Daxxn/GarminAPController/Docs/Renders/APController_PCB_Front1.JPG

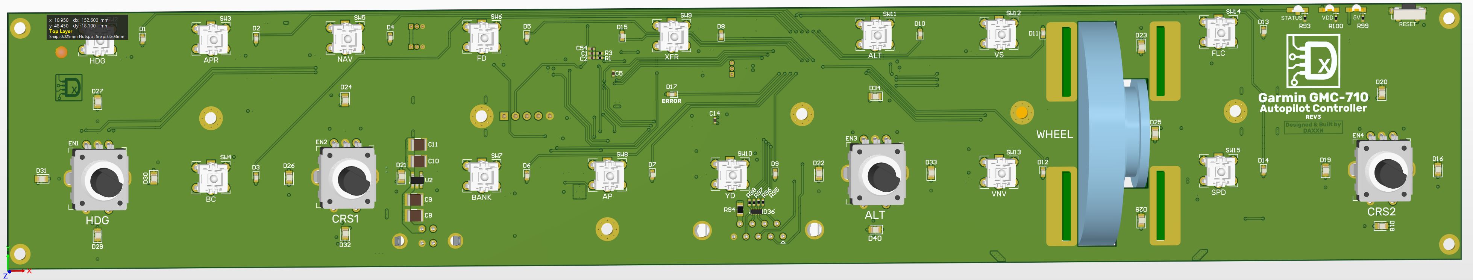
Docs/Renders/APController_PCB_Front1.JPG
