Daxxn/GarminAPController/Docs/Renders/APController_Assembly_Back2.JPG

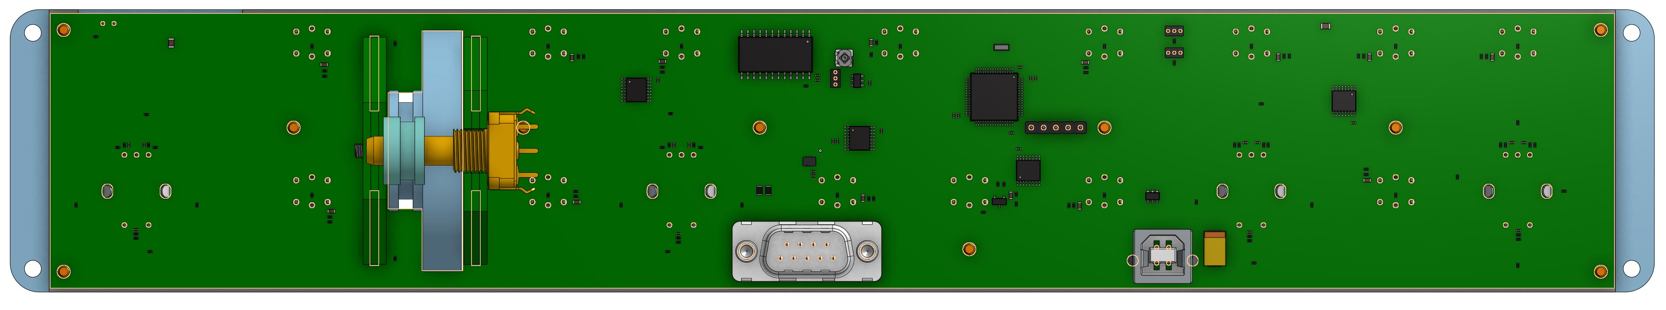
Docs/Renders/APController_Assembly_Back2.JPG
