Daxxn/GarminAPController/Docs/Renders/APController_Assembly_Front1.JPG

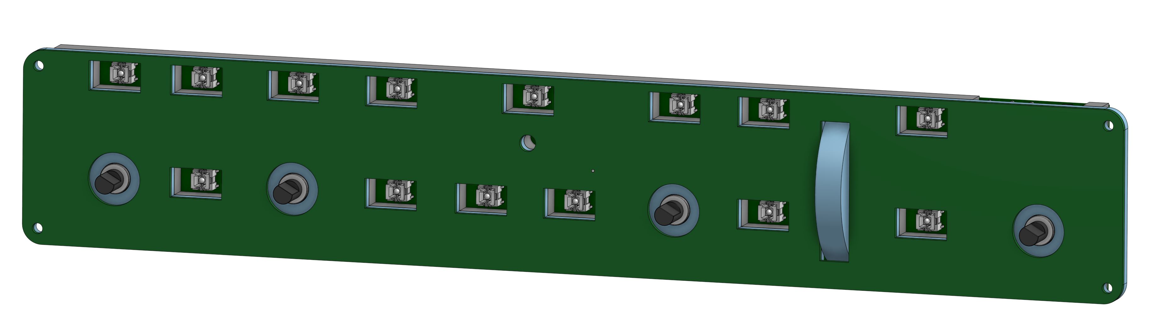
Docs/Renders/APController_Assembly_Front1.JPG
