Daxxn/GarminAPController/Docs/GarminAutopilotREV3.pdf

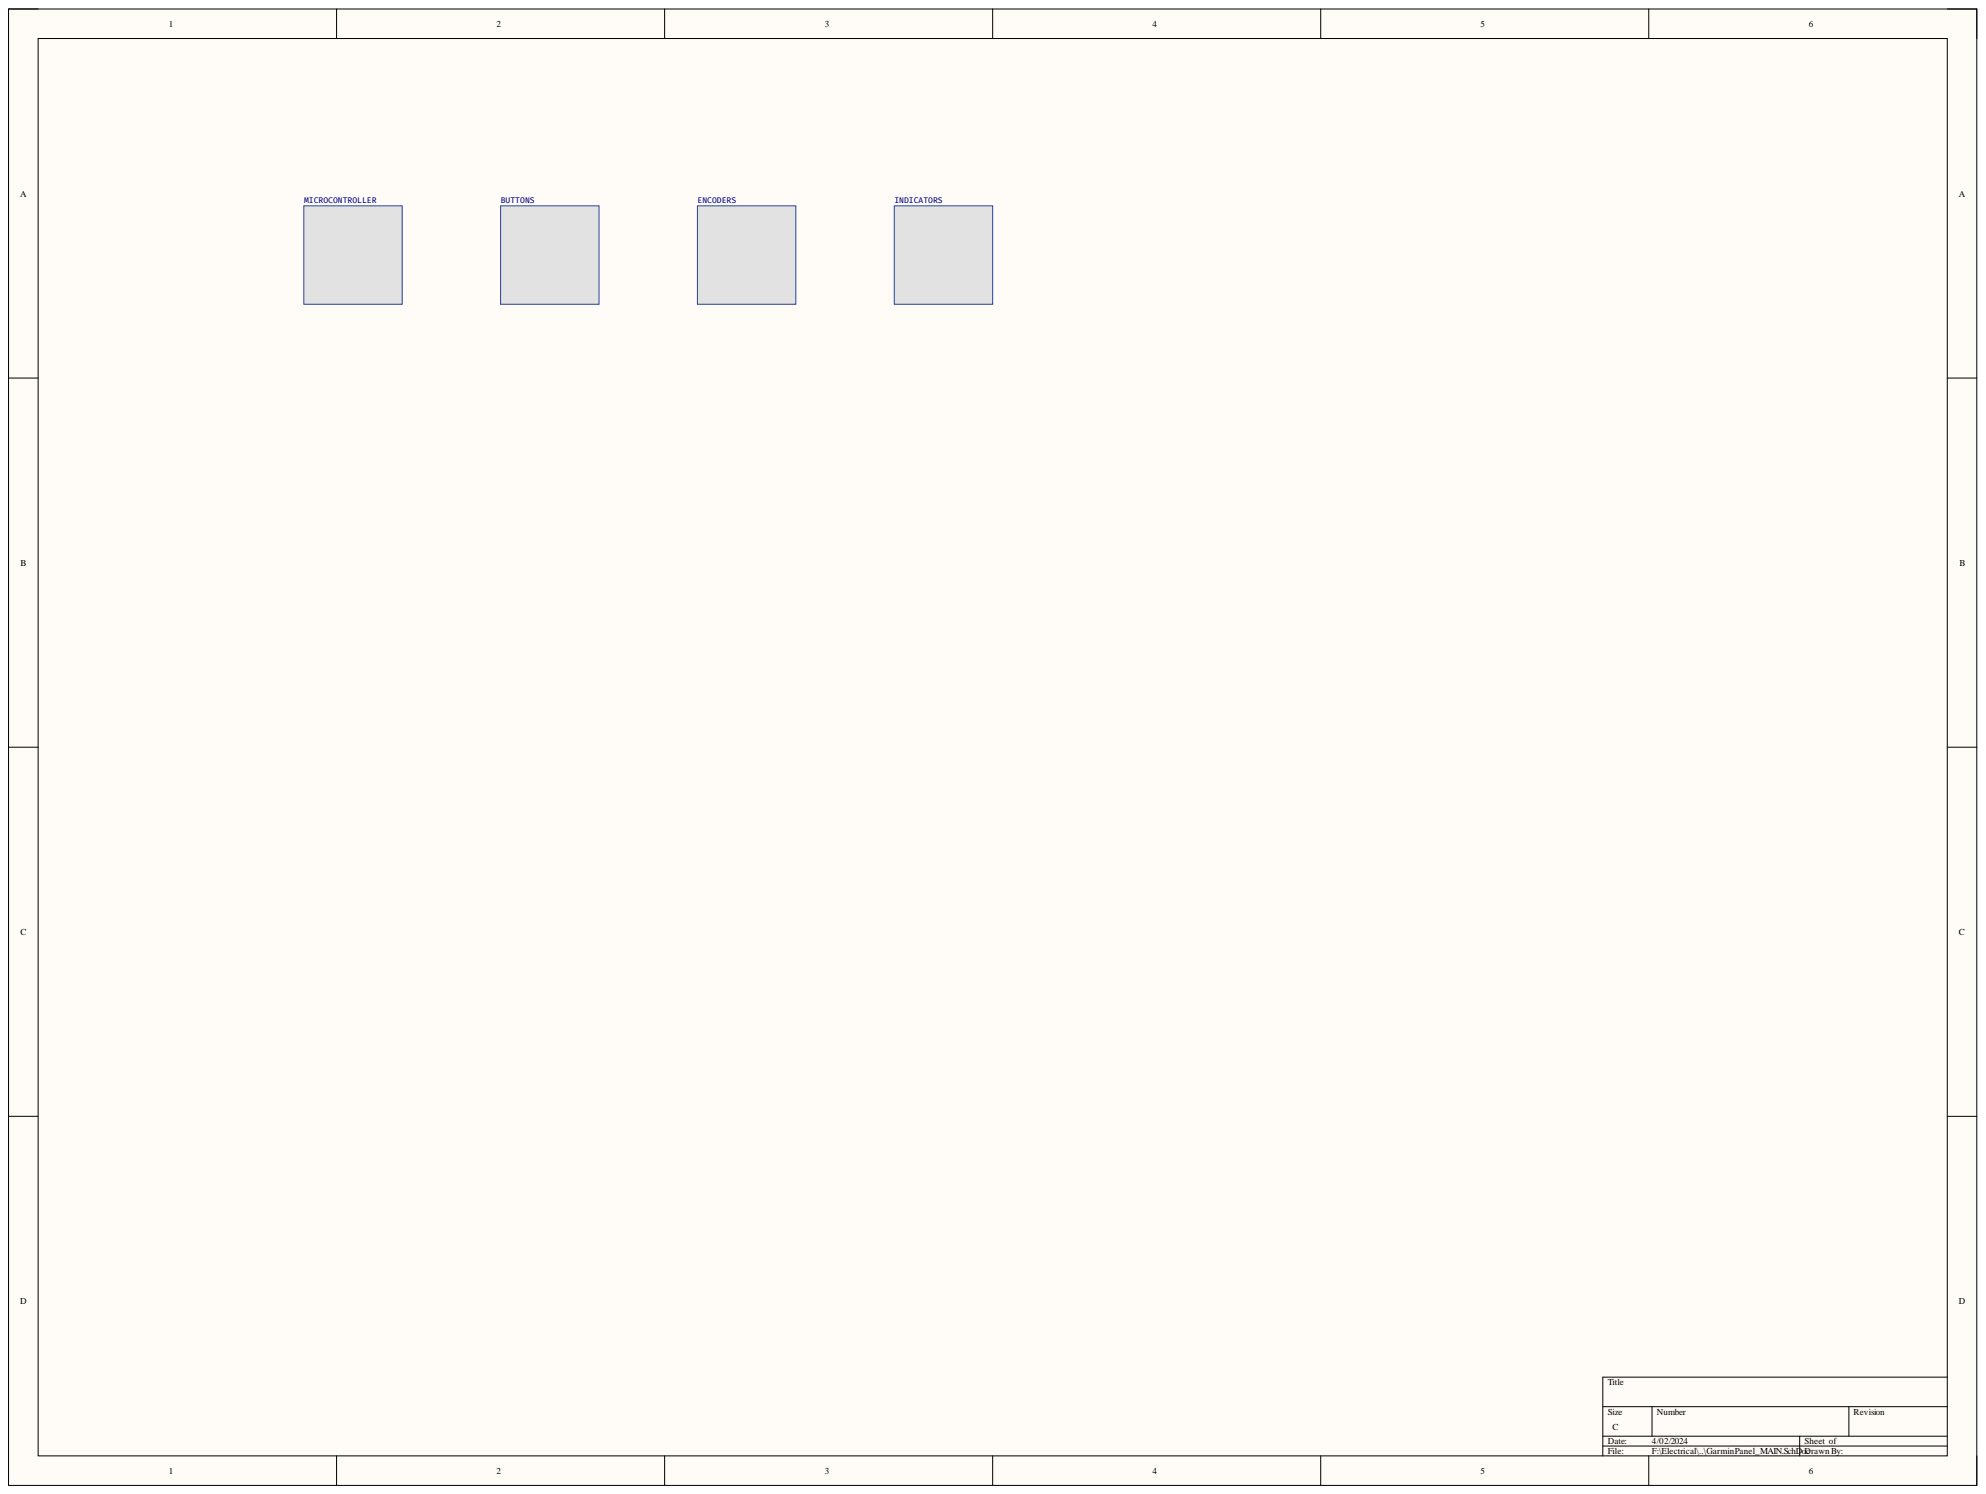
[picture p11: page 1]

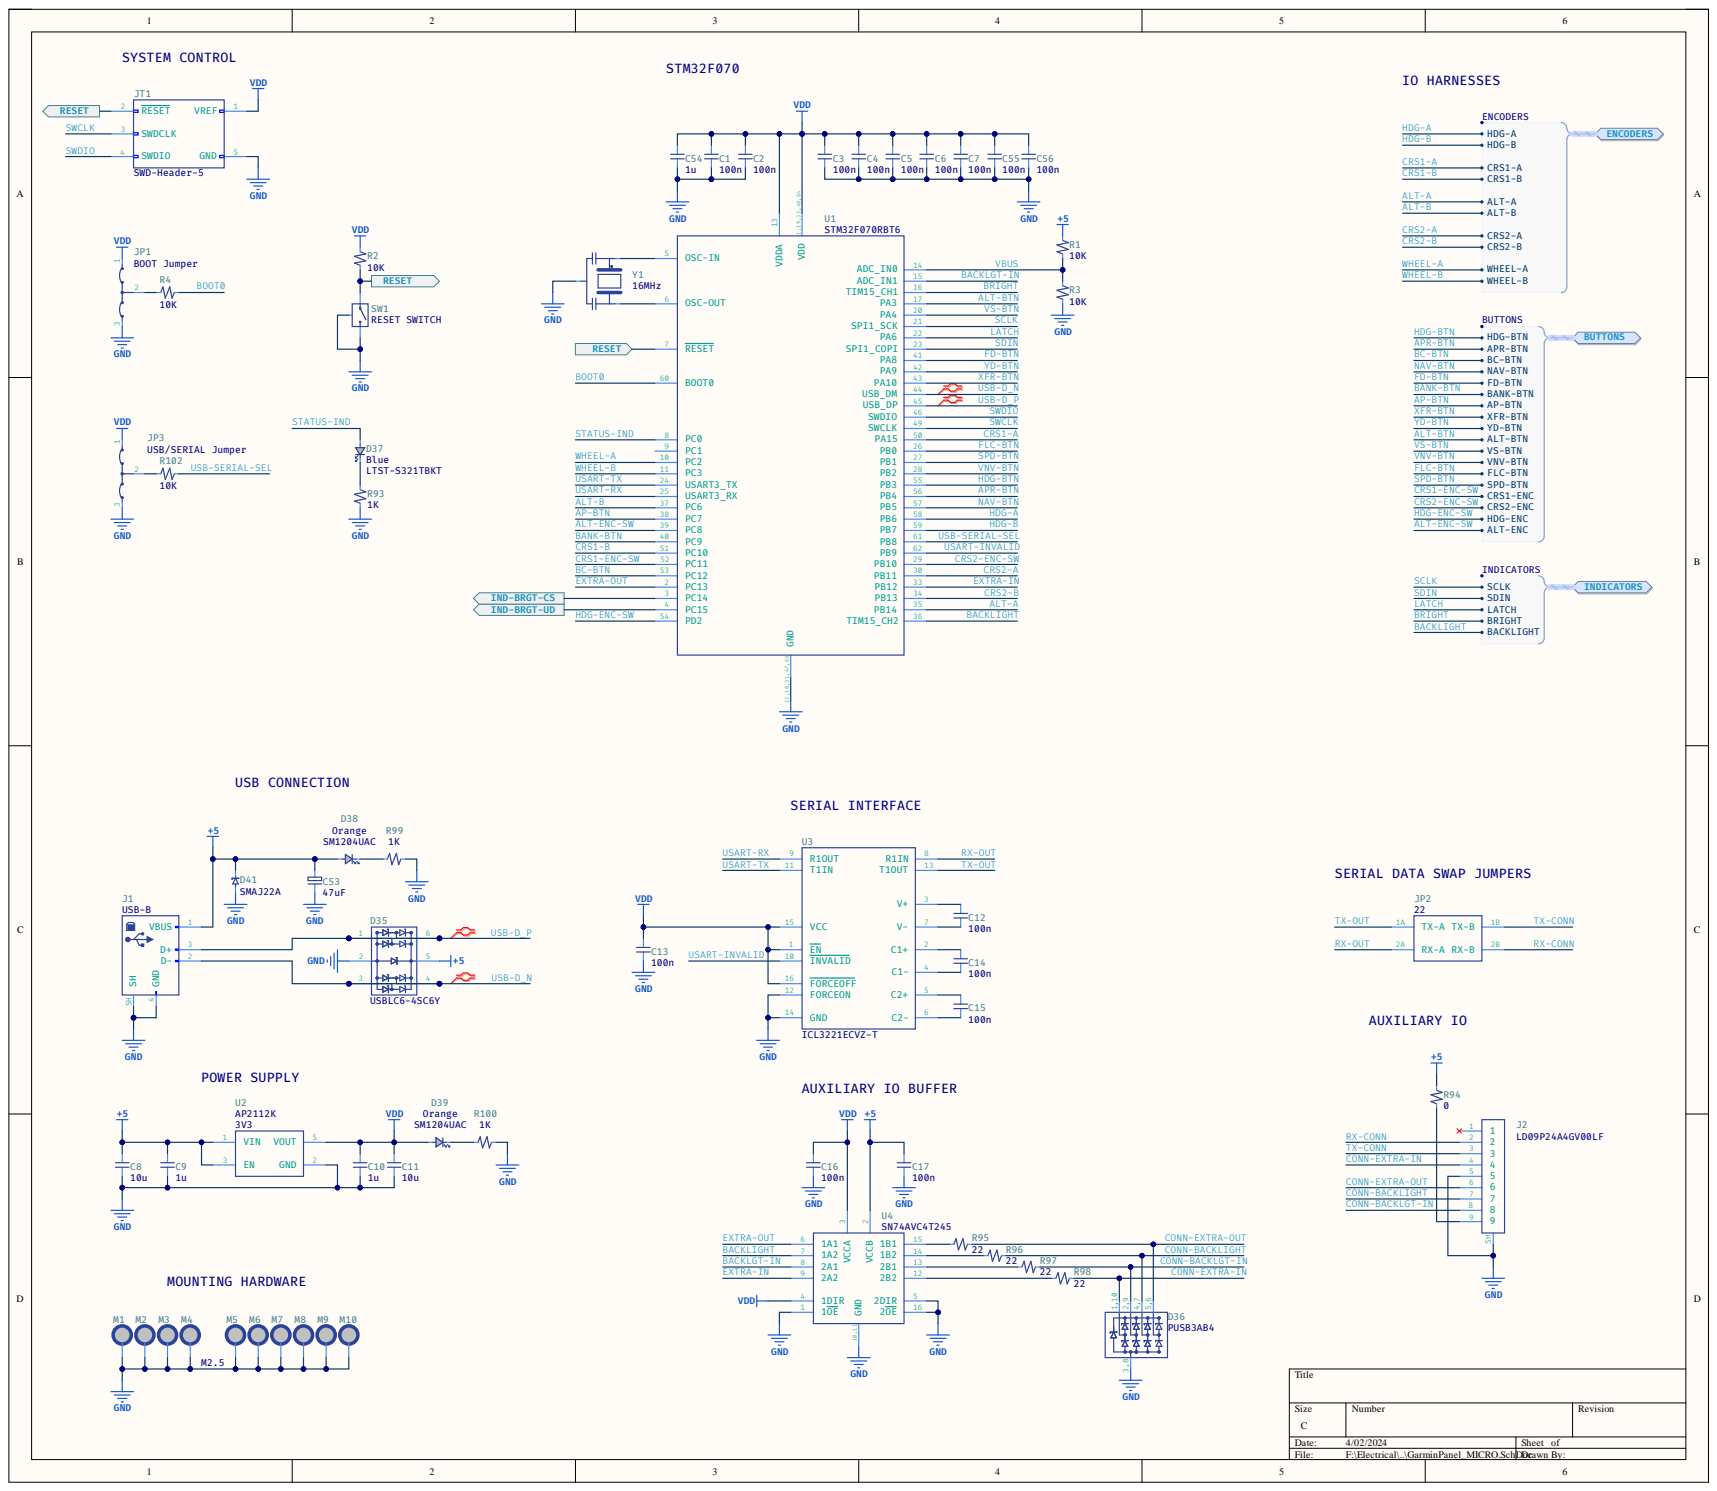
[picture p12: page 2]

SERIAL DATA SWAP JUMPERS

AUXILIARY IO BUFFER POWER SUPPLY

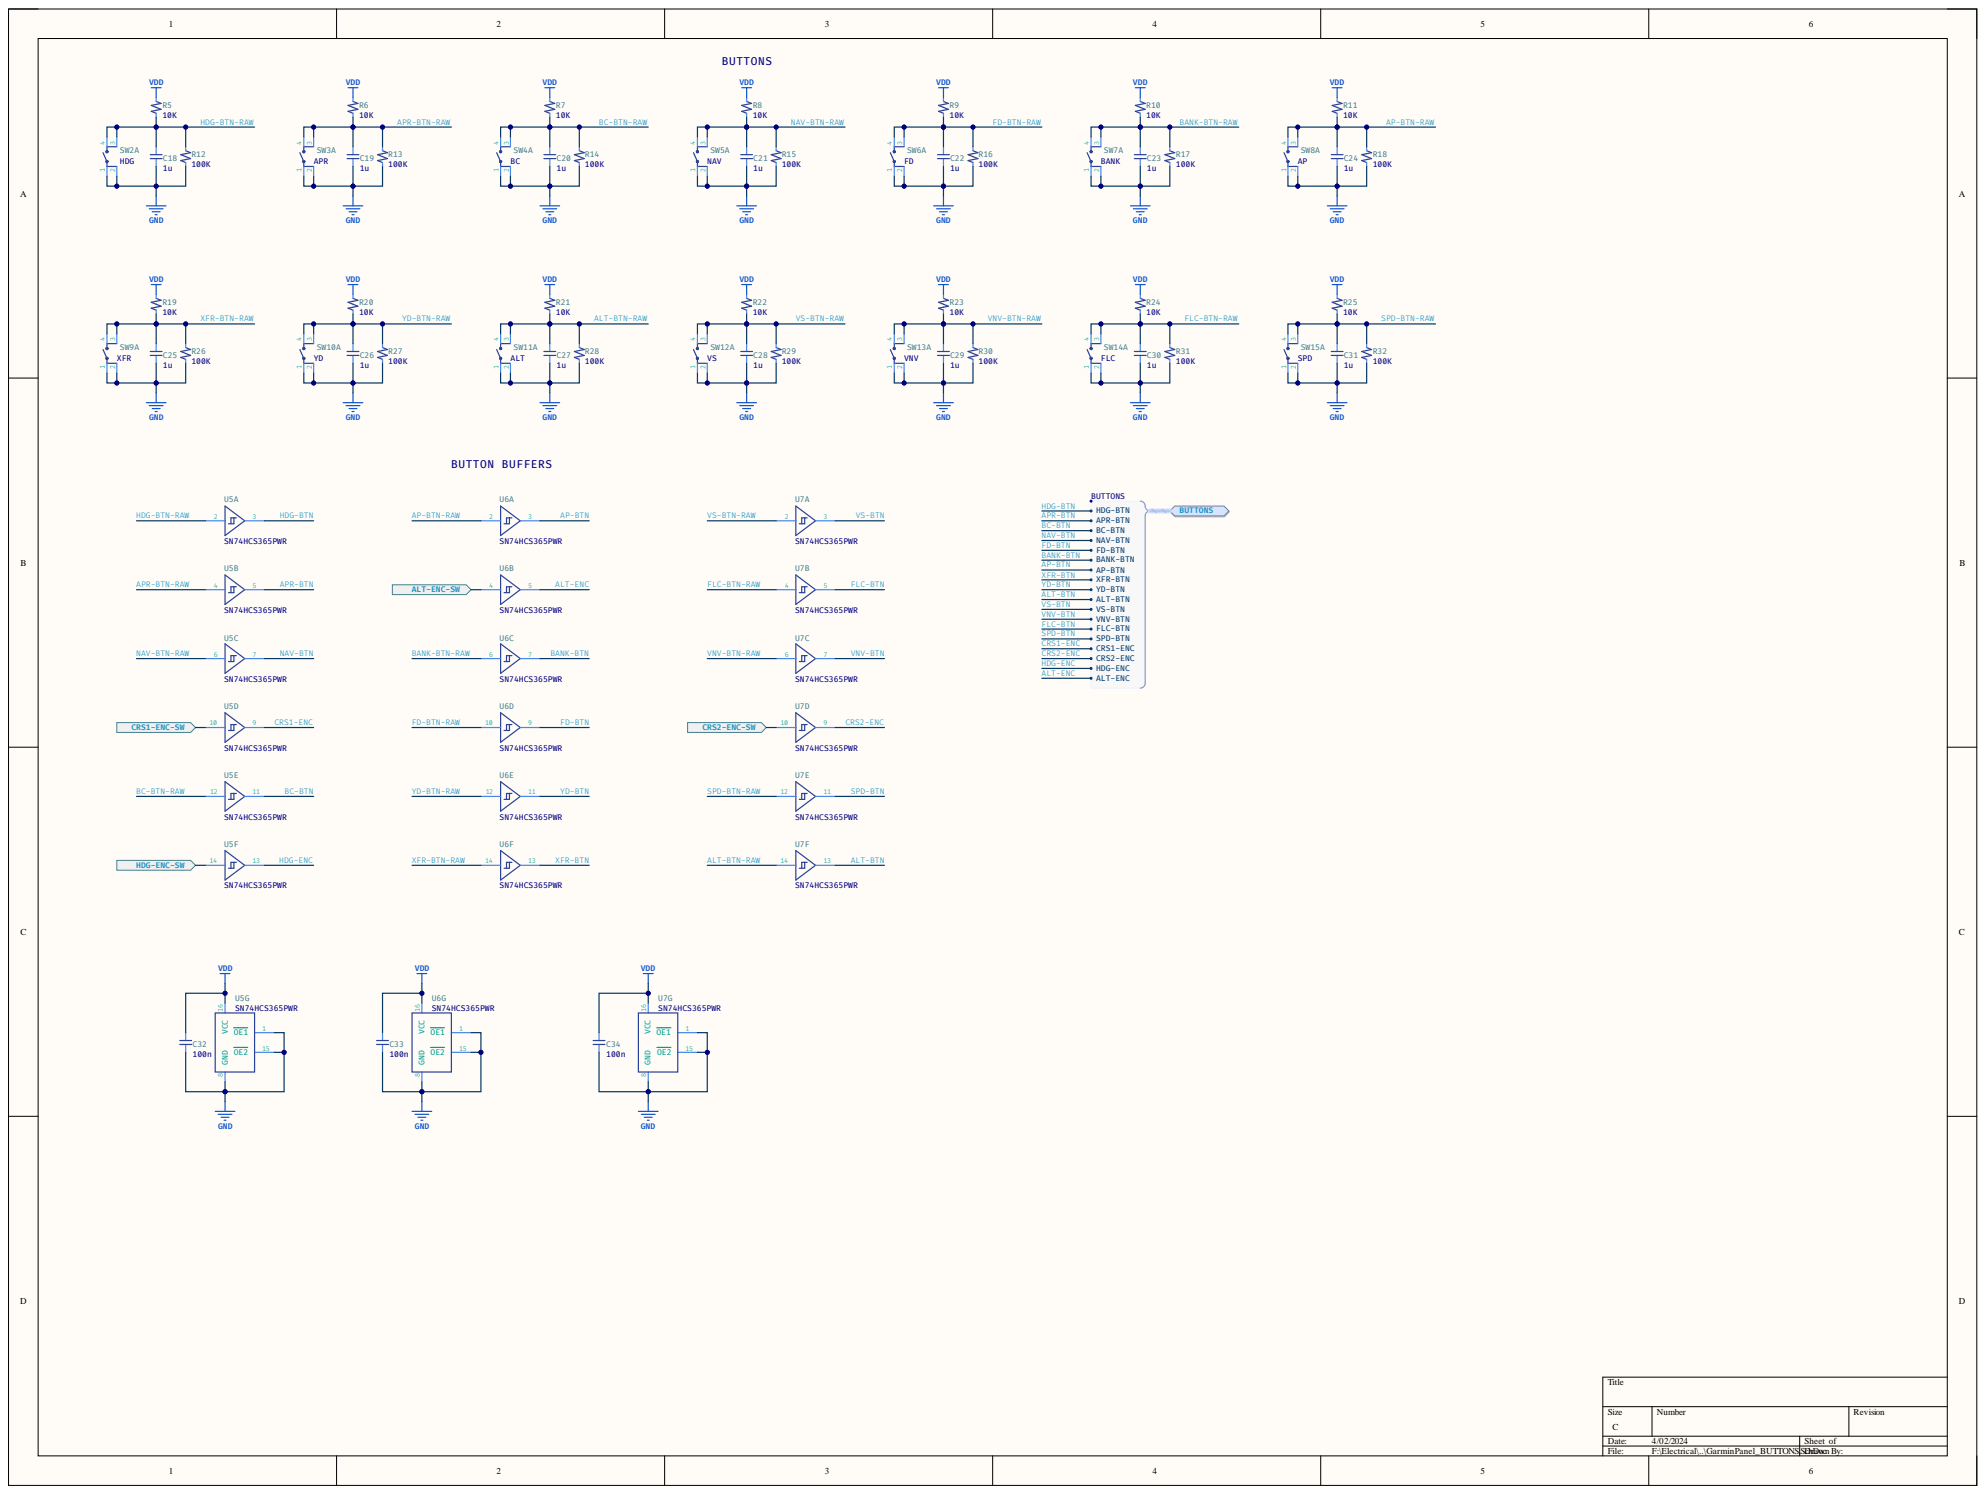
[picture p13: page 3]

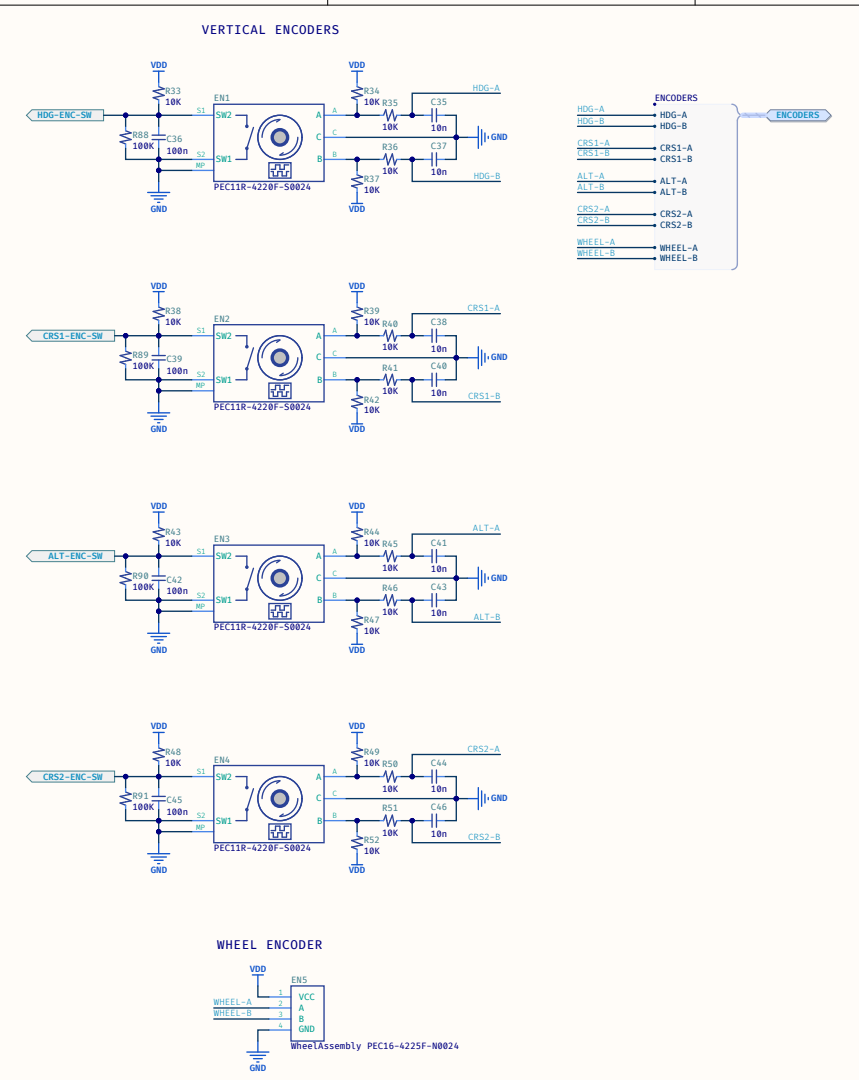
[picture p14: page 4]

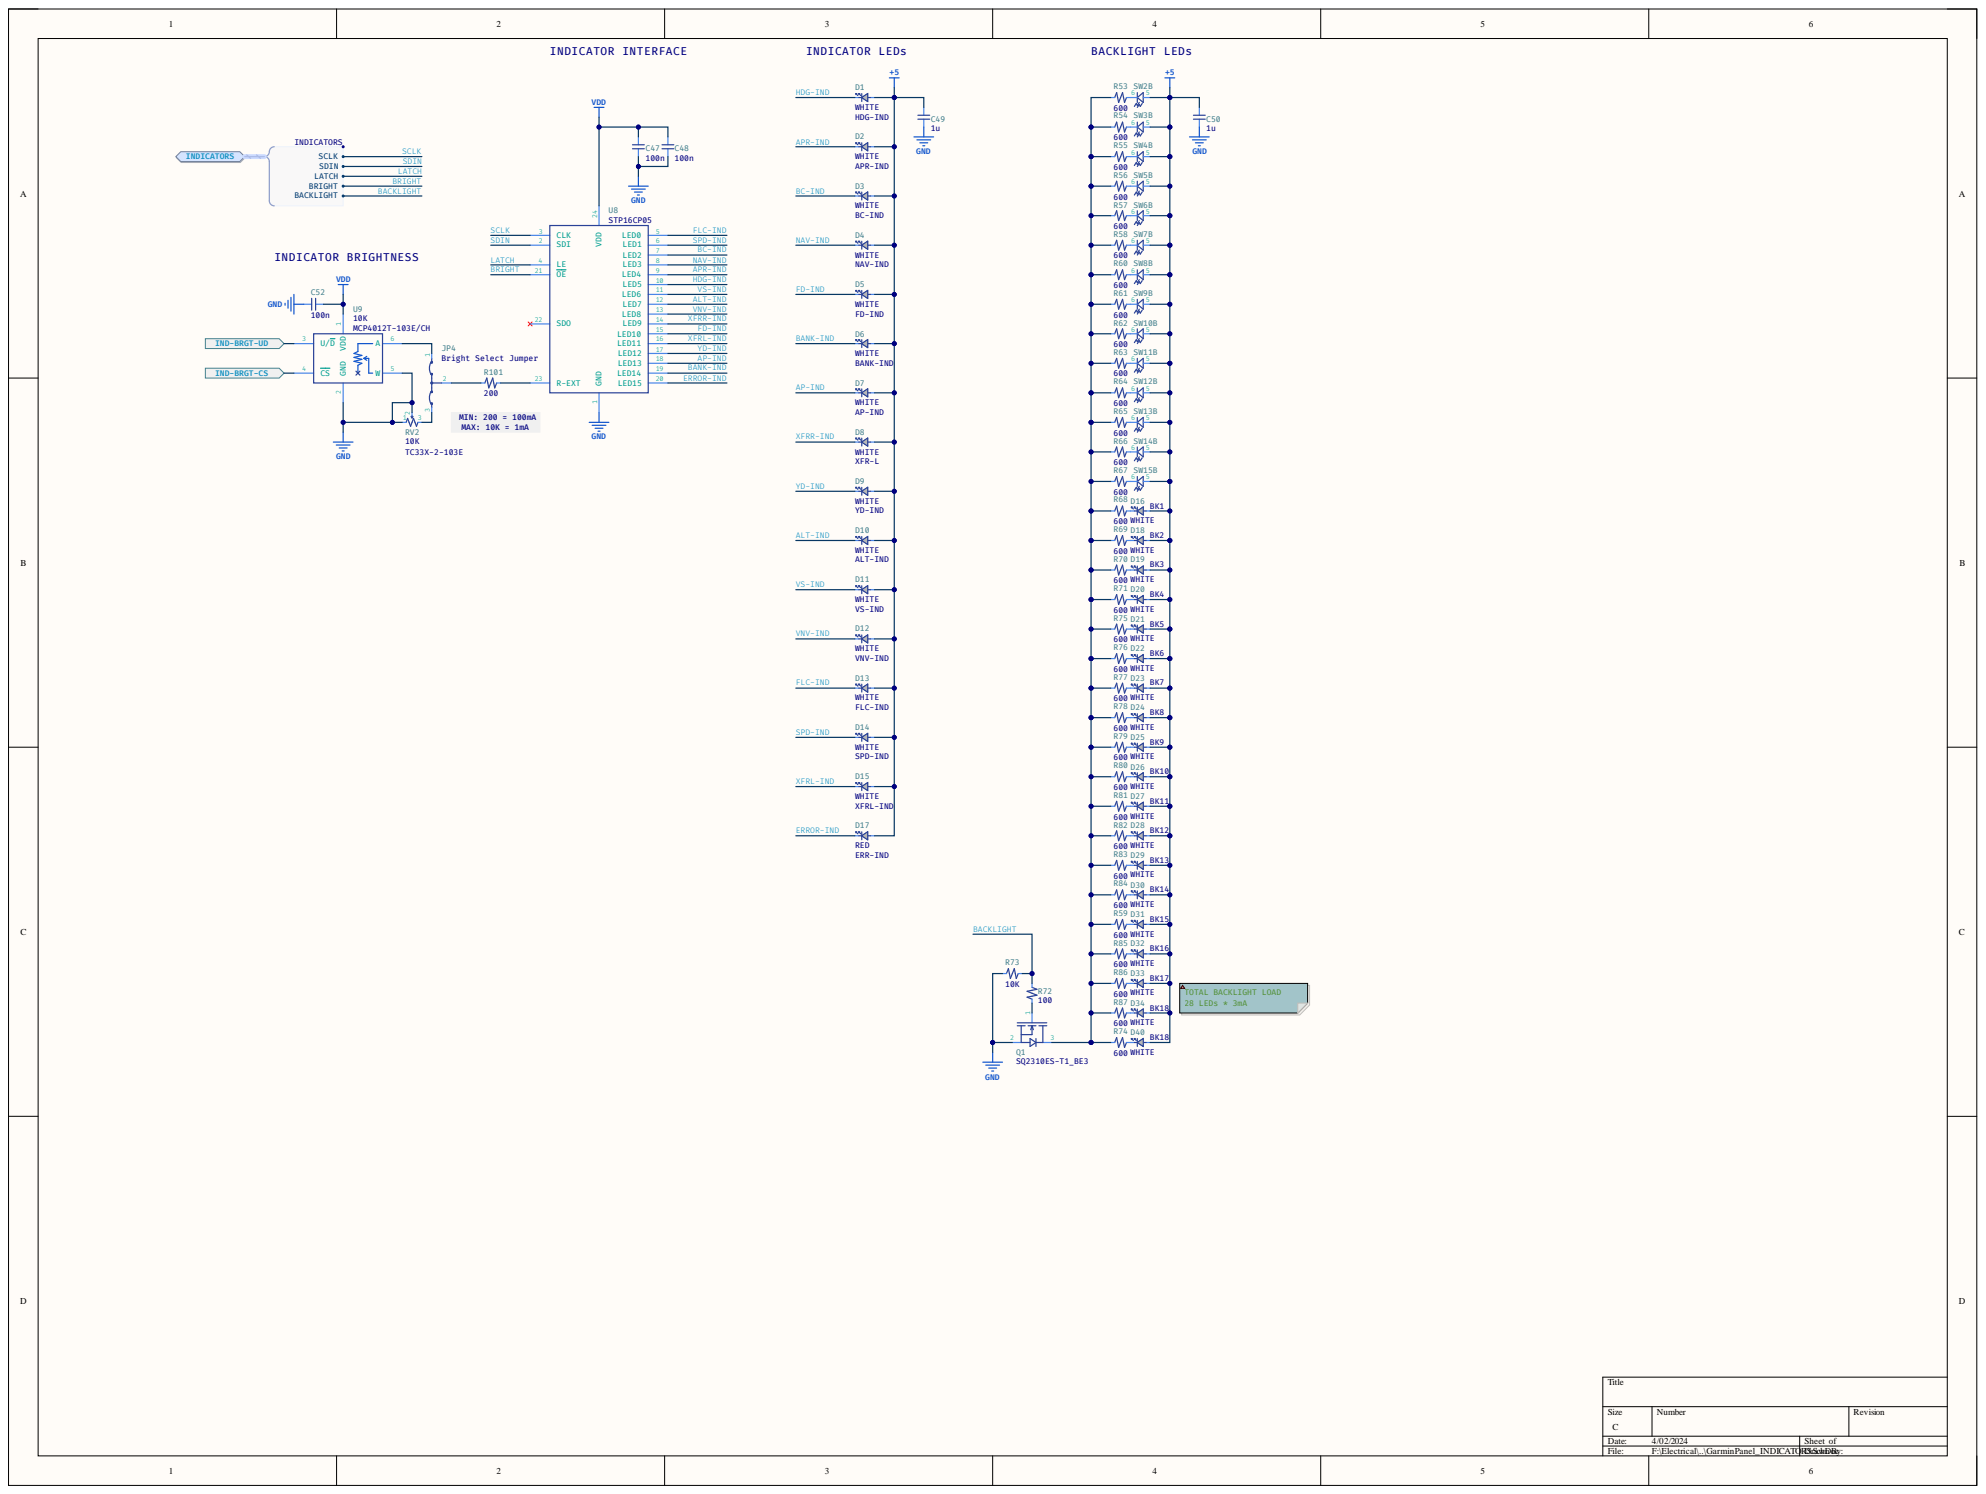
[picture p15: page 5]

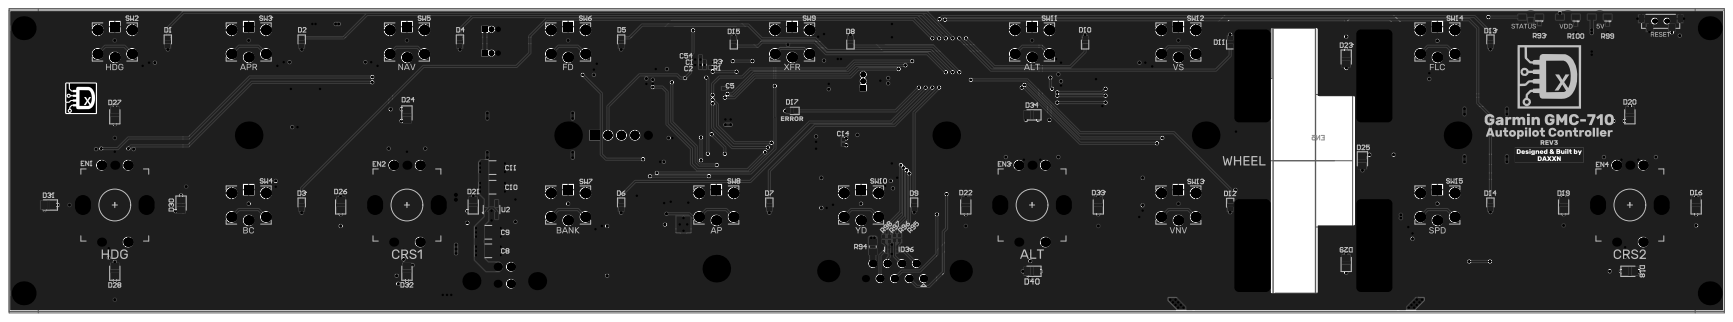
[picture p16: page 6]
