Daxxn/GarminAPController/Core/Src/main.c

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
/* Includes ------------------------------------------------------------------*/
#include "main.h"
#include "usb_device.h"

ADC_HandleTypeDef hadc;

SPI_HandleTypeDef hspi1;

TIM_HandleTypeDef htim1;
TIM_HandleTypeDef htim7;
TIM_HandleTypeDef htim15;

UART_HandleTypeDef huart3;

void SystemClock_Config(void);
static void MX_GPIO_Init(void);
static void MX_SPI1_Init(void);
static void MX_TIM15_Init(void);
static void MX_USART3_UART_Init(void);
static void MX_ADC_Init(void);
static void MX_TIM1_Init(void);
static void MX_TIM7_Init(void);
/* USER CODE BEGIN 0 */
void HAL_GPIO_EXTI_Callback(uint16_t GPIO_Pin)
{
	EncInterruptCallback(GPIO_Pin);
}

void HAL_TIM_PeriodElapsedCallback(TIM_HandleTypeDef *htim)
{
	TimerElapsedCallback(htim);
}
/* USER CODE END 0 */

/**
  * @brief  The application entry point.
  * @retval int
  */
int main(void)
{

  /* MCU Configuration--------------------------------------------------------*/

  /* Reset of all peripherals, Initializes the Flash interface and the Systick. */
  HAL_Init();

  /* Configure the system clock */
  SystemClock_Config();

  /* Initialize all configured peripherals */
  MX_GPIO_Init();
  MX_SPI1_Init();
  MX_TIM15_Init();
  MX_USART3_UART_Init();
  MX_USB_DEVICE_Init();
  MX_ADC_Init();
  MX_TIM1_Init();
  MX_TIM7_Init();
  /* USER CODE BEGIN 2 */
  HAL_Delay(200);
  if (Init(&hadc, &hspi1, &htim15, &huart3, &htim7) != HAL_OK)
  {
	  Error_Handler();
  }
  /* USER CODE END 2 */

  /* Infinite loop */
  /* USER CODE BEGIN WHILE */
  while (1)
  {
	  Main();
    /* USER CODE END WHILE */

    /* USER CODE BEGIN 3 */
  }
  /* USER CODE END 3 */
}

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
